PawelWilczewski/weti_indeks/img/obw1.JPG

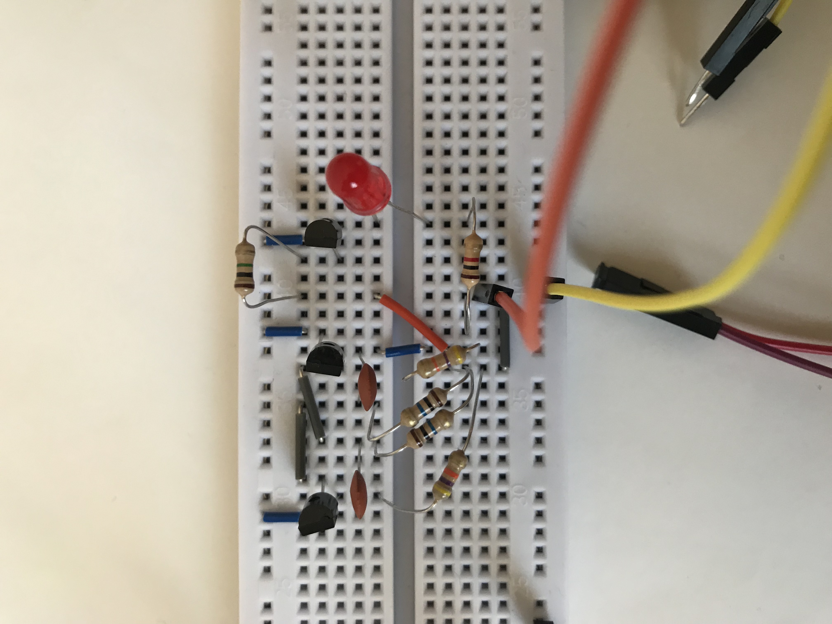
img/obw1.JPG
