PawelWilczewski/weti_indeks/img/obudowa.png

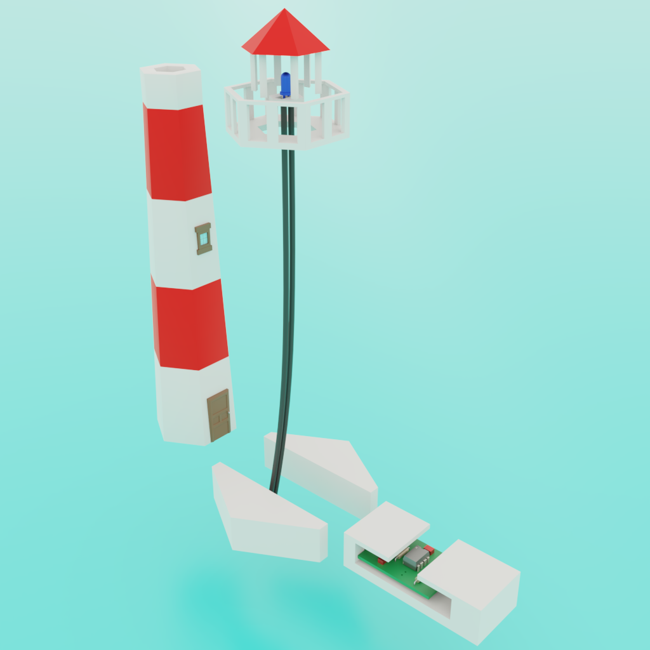
img/obudowa.png
