PawelWilczewski/weti_indeks/koszty.pdf

LP. | Przedmiot | Sztuk | Średnia cena za szt. | Cena | Link
1 | Timer 555 CMOS | 1 | 2.80 zł | 2.80 zł | https://kamami.pl/timery/19669-icm555.html
2 | Rezystor R1 1 MΩ | 1 | 0.02 zł | 0.02 zł | https://botland.com.pl/pl/zestawy-rezystorow/1039-zestaw-rezystorow-cf-tht-14w-
opisany-1000szt.html (https://botland.com.pl/pl/zestawy-rezystorow/1039-zestaw-rezystorow-cf-tht-14w-opisany-1000szt.html)
3 | Rezystor R2 6.8 MΩ | 1 | 0.20 zł | 0.20 zł | https://www.aprovi.pl/produkt/rezystor-weglowy-6m8-1w-%C2%B15/
4 | Rezystor R3 470 Ω | 1 | 0.02 zł | 0.02 zł | https://botland.com.pl/pl/zestawy-rezystorow/1039-zestaw-rezystorow-cf-tht-14w-
opisany-1000szt.html (https://botland.com.pl/pl/zestawy-rezystorow/1039-zestaw-rezystorow-cf-tht-14w-opisany-1000szt.html)
5 | Dioda LED | 1 | 0.16 zł | 0.16 zł | https://botland.com.pl/pl/diody-led/4741-zestaw-diod-led-5mm-16szt.html
6 | Kondensator 100 nF | 1 | 0.07 zł | 0.07 zł | https://botland.com.pl/pl/zestawy-kondensatorow/2146-zestaw-kondensatorow-ceramicznych-tht-100szt.html (https://botland.com.pl/pl/zestawy-kondensatorow/2146-zestaw-kondensatorow-ceramicznych-tht-100szt.html)
7 | Zworka | 2 | 0.10 zł | 0.20 zł | https://botland.com.pl/pl/zworki/556-zworka-jumper-10szt.html
8 | Gniazdo USB typu A | 1 | 0.70 zł | 0.70 zł | https://botland.com.pl/pl/zlacza-usb/1329-gniazdo-usb-typu-a-zenskie-tht.html
9 | Wtyk goldpin | 4 | 0.02 zł | 0.07 zł | https://botland.com.pl/pl/gniazda-szpilkowe-goldpin/192-wtyk-goldpin-1x40-prosty-raster-254mm.html (https://botland.com.pl/pl/gniazda-szpilkowe-goldpin/192-wtyk-goldpin-1x40-prosty-raster-254mm.html)
10 | Wykonanie PCB | 1 | 42.16 zł | 42.16 zł | https://www.prototypy.com/sites_pcbplugins/pcborder/58
| | | SUMA | 46.39 zł
| | | SUMA bez PCB | 4.23 zł

Tabela z kosztem elementów wykorzystanych do budowy Ekomigacza
