PawelWilczewski/weti_indeks/img/ATTiny45_Program.png

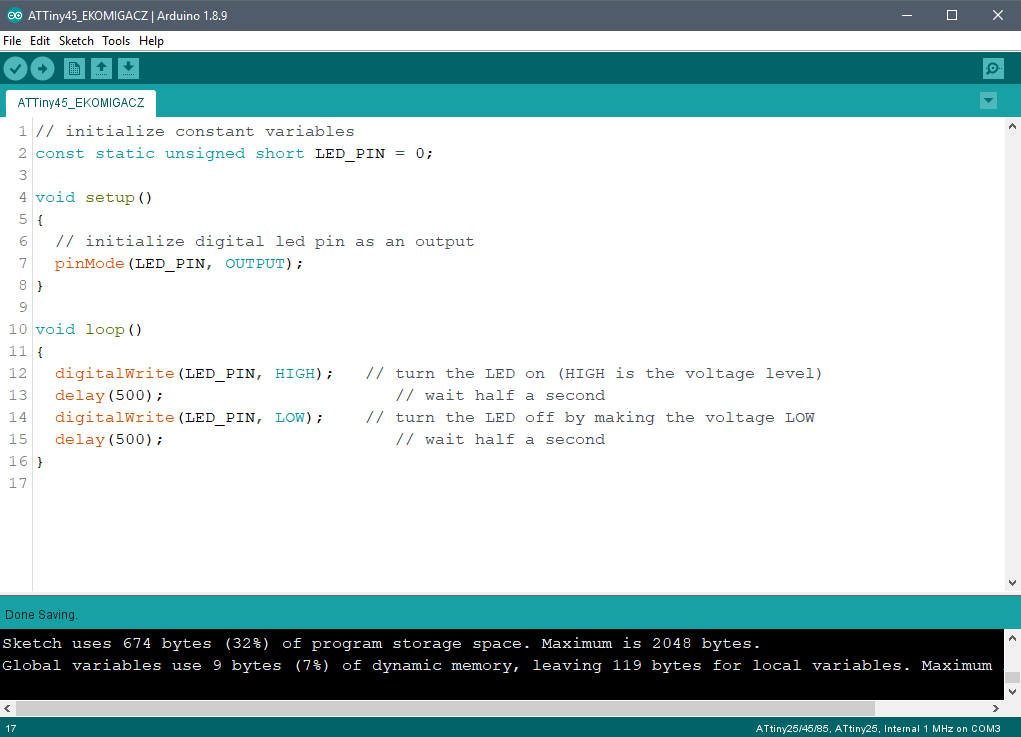
img/ATTiny45_Program.png
