PawelWilczewski/weti_indeks/img/czas.png

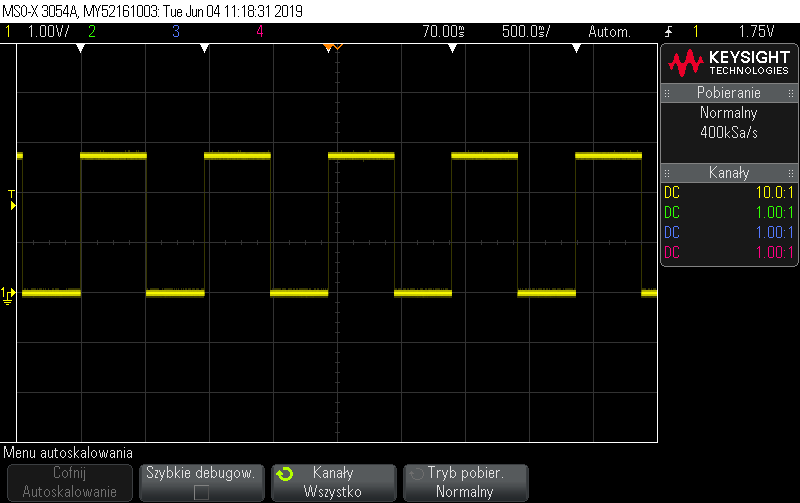
img/czas.png
