PawelWilczewski/weti_indeks/img/dioda.png

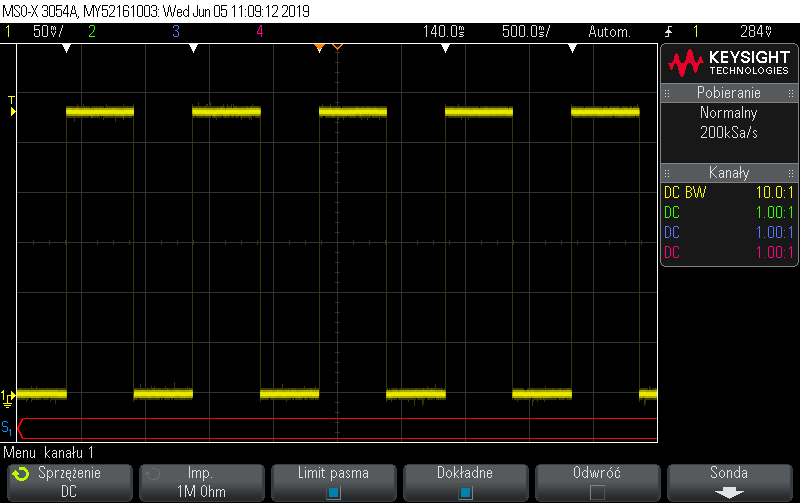
img/dioda.png
