PawelWilczewski/weti_indeks/img/IMG_3310.JPG

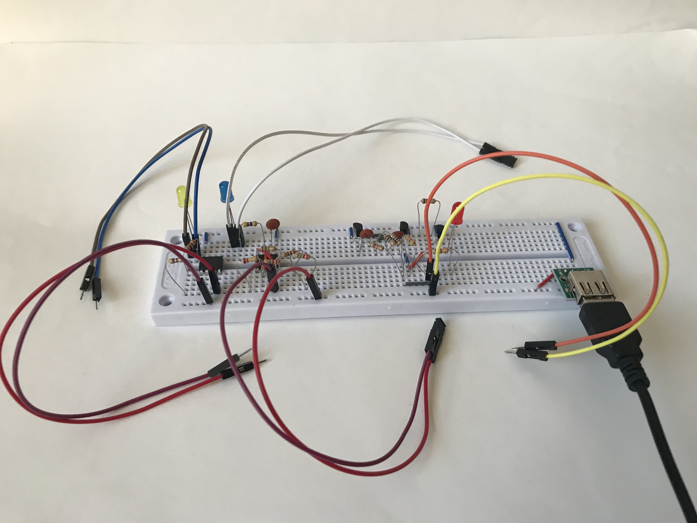
img/IMG_3310.JPG
