PawelWilczewski/weti_indeks/img/IMG_3311.JPG

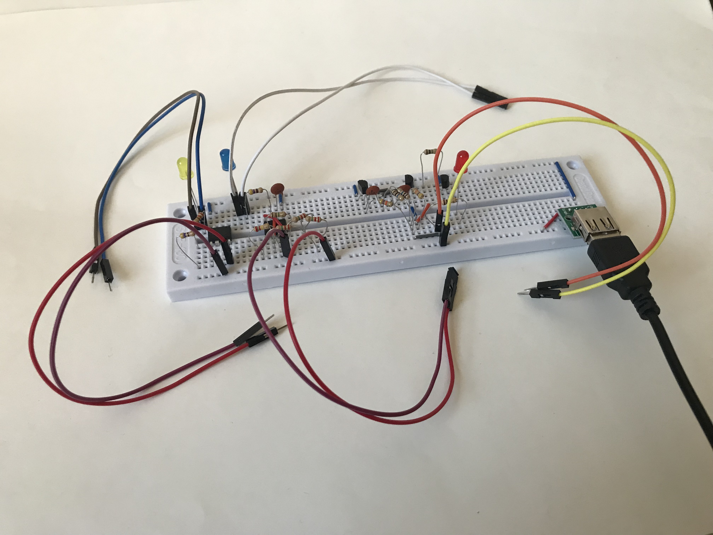
img/IMG_3311.JPG
