PawelWilczewski/weti_indeks/img/IMG_3313.JPG

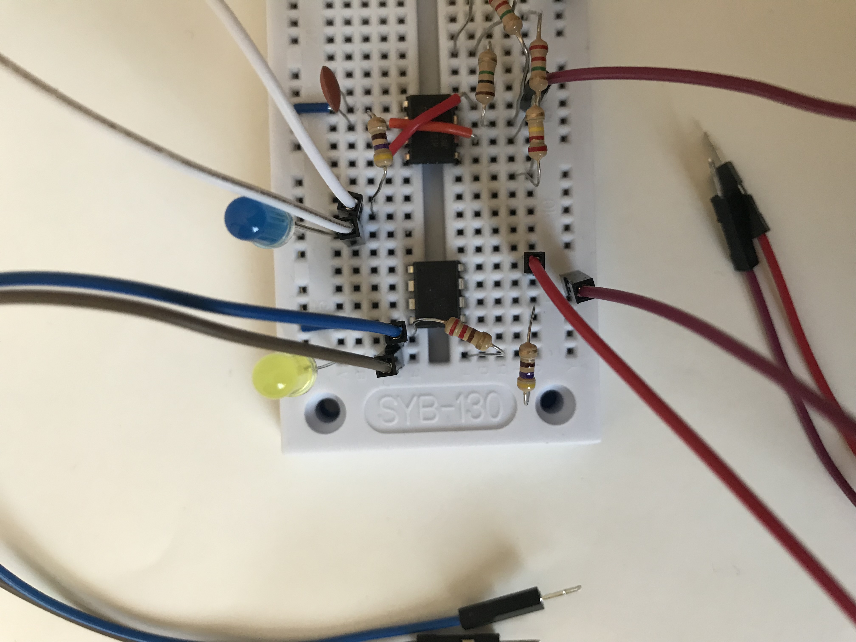
img/IMG_3313.JPG
