PawelWilczewski/weti_indeks/img/IMG_3314.JPG

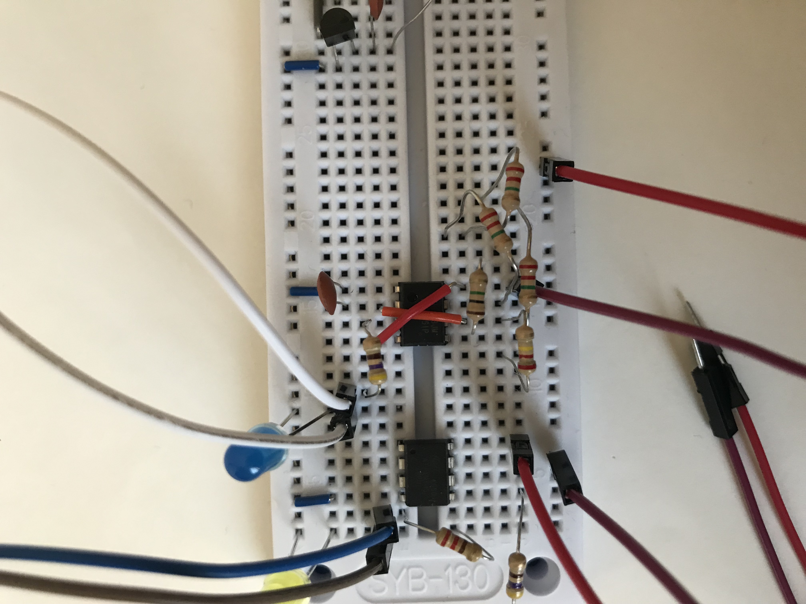
img/IMG_3314.JPG
