PawelWilczewski/weti_indeks/img/IMG_3316.JPG

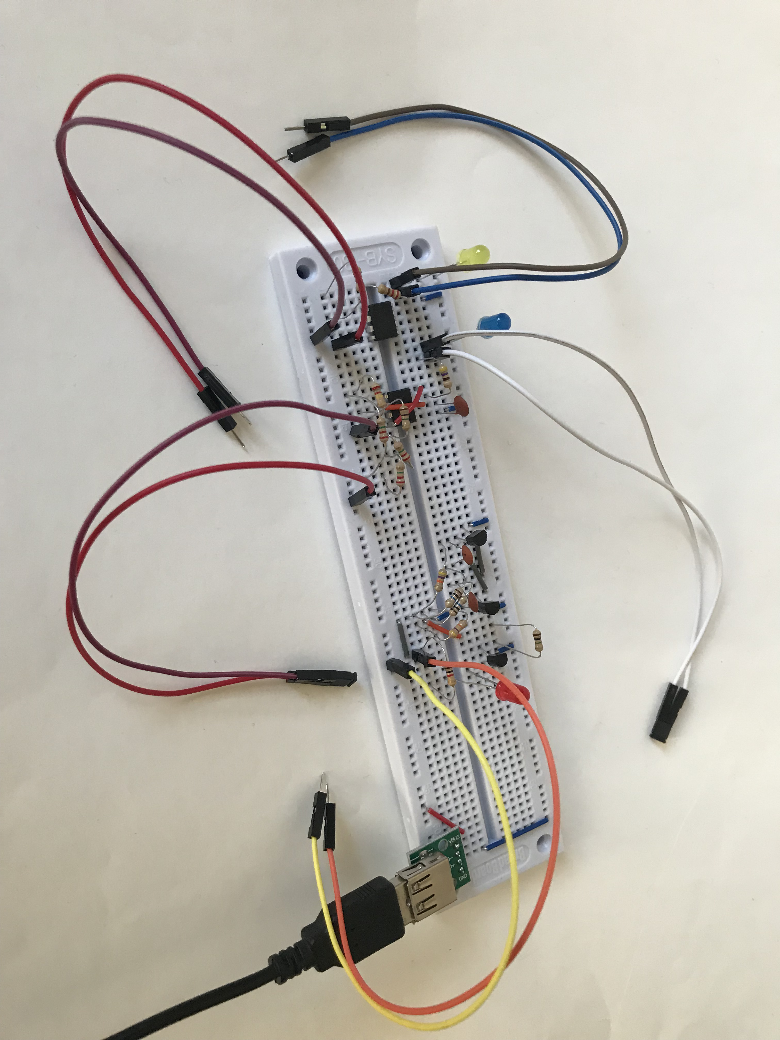
img/IMG_3316.JPG
