PawelWilczewski/weti_indeks/img/IMG_3317.JPG

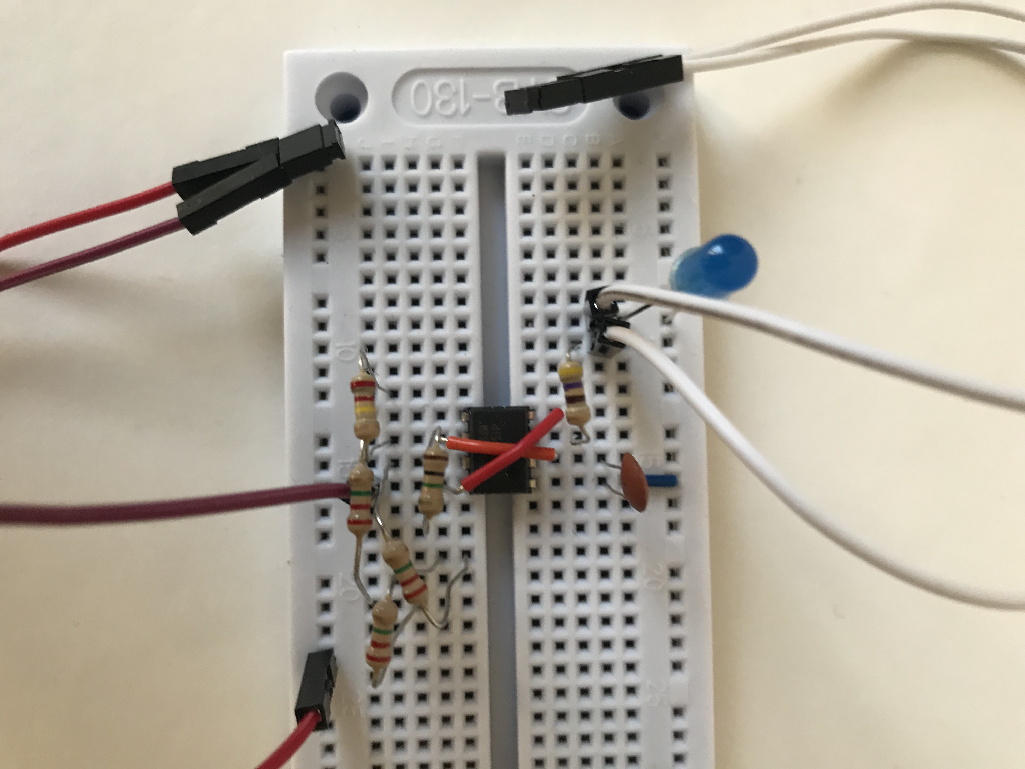
img/IMG_3317.JPG
