PawelWilczewski/weti_indeks/img/IMG_3318.JPG

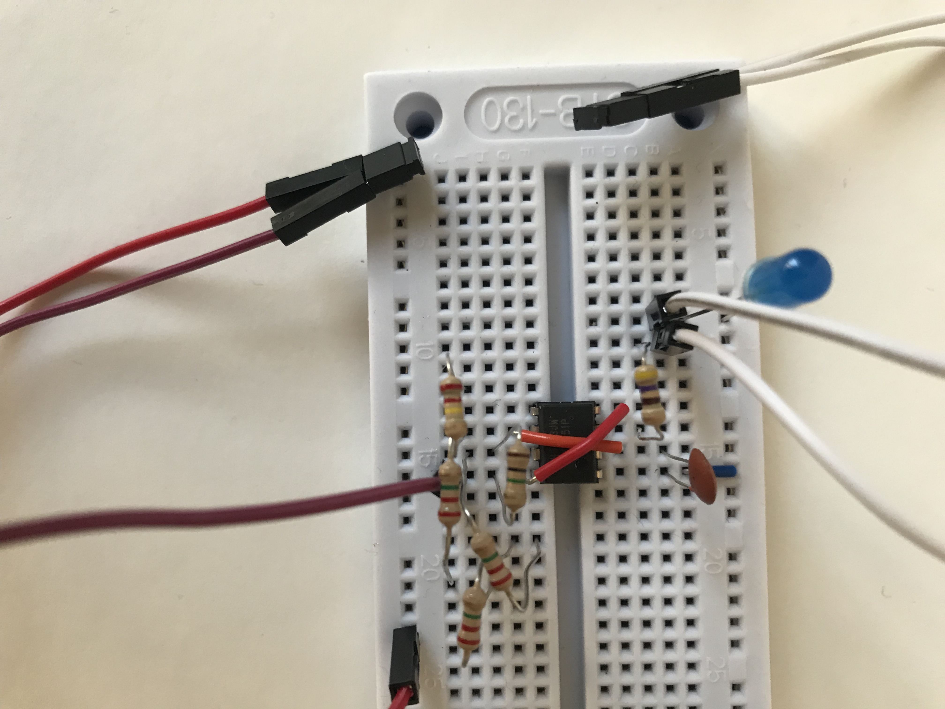
img/IMG_3318.JPG
