PawelWilczewski/weti_indeks/img/IMG_3319.JPG

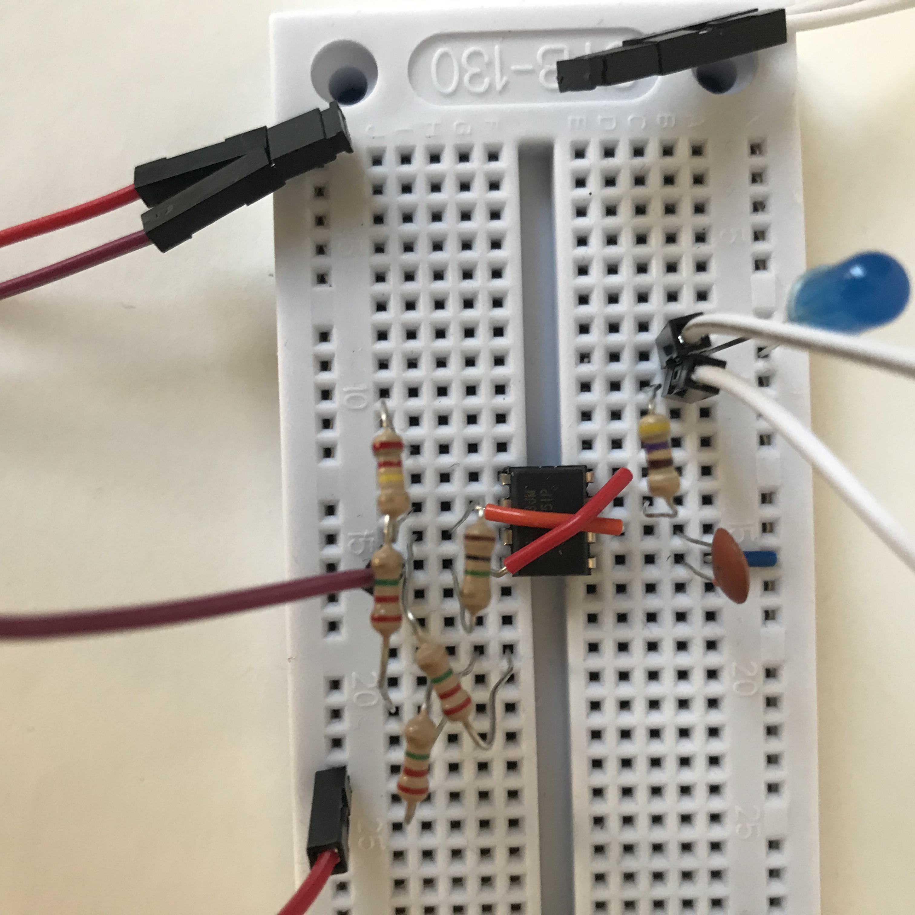
img/IMG_3319.JPG
