PawelWilczewski/weti_indeks/img/latarnia_real.jpg

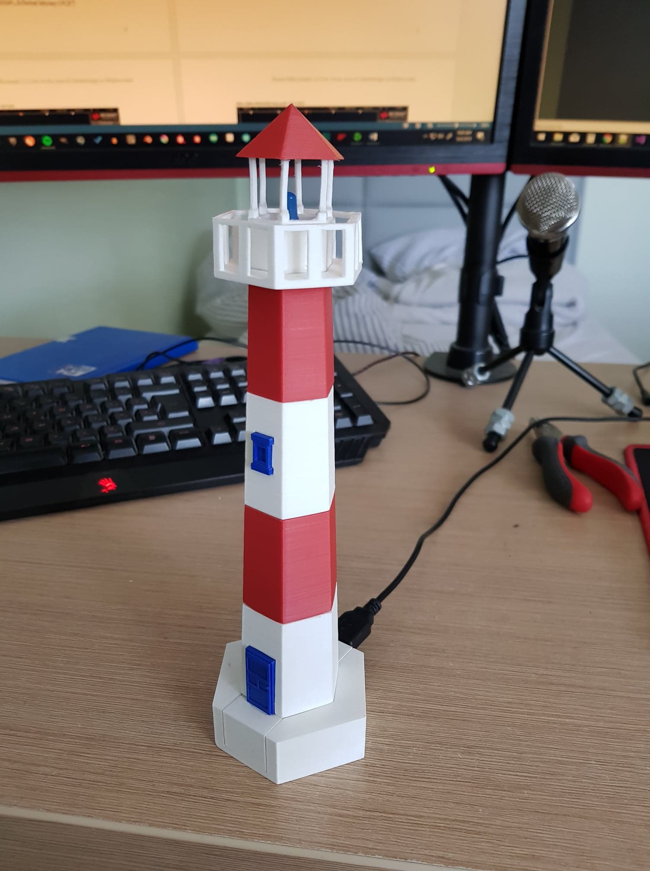
img/latarnia_real.jpg
