PawelWilczewski/weti_indeks/img/latarnia_real.png

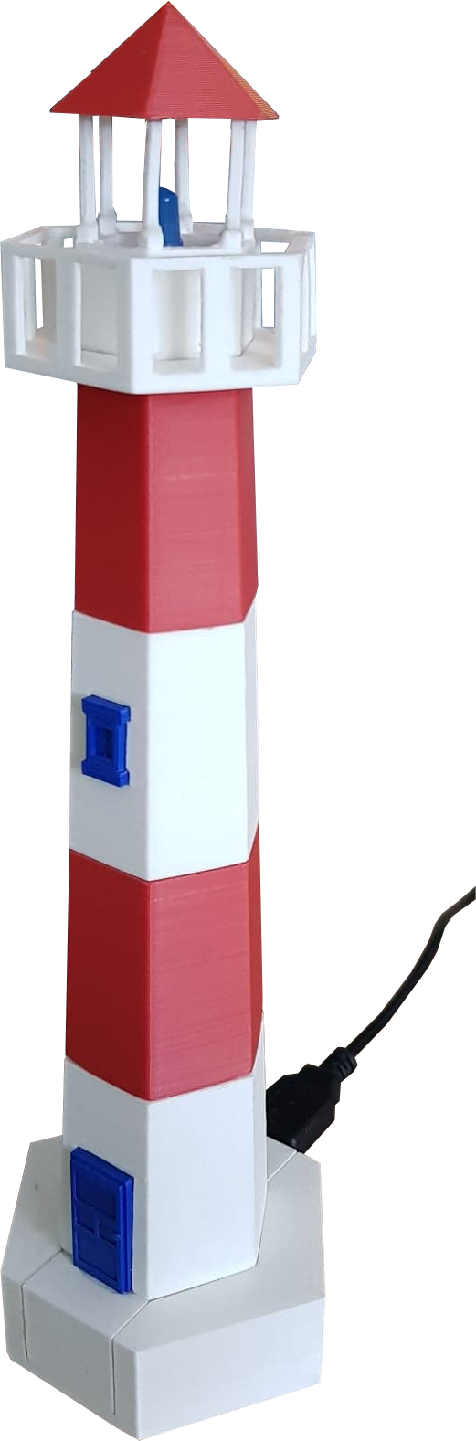
img/latarnia_real.png
