PawelWilczewski/weti_indeks/img/pomiar.png

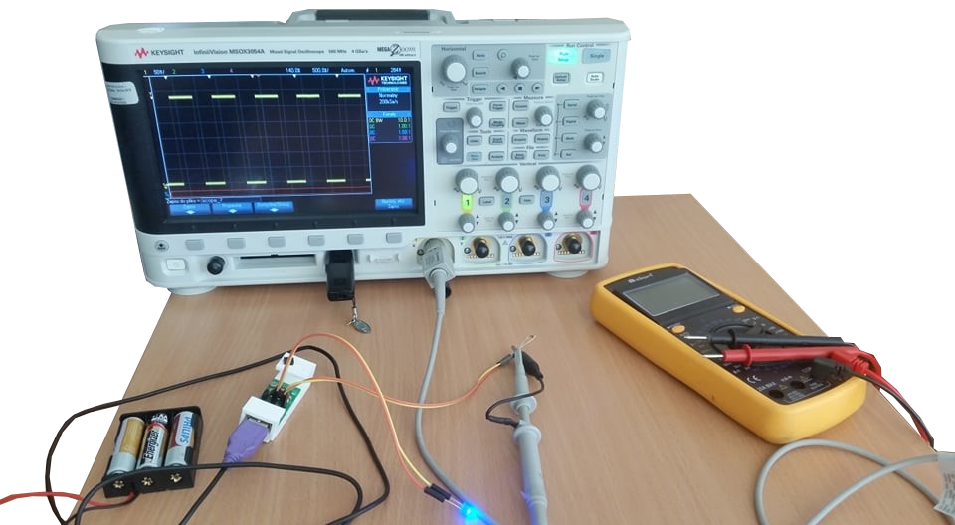
img/pomiar.png
