PawelWilczewski/weti_indeks/img/pomiar_tr.png

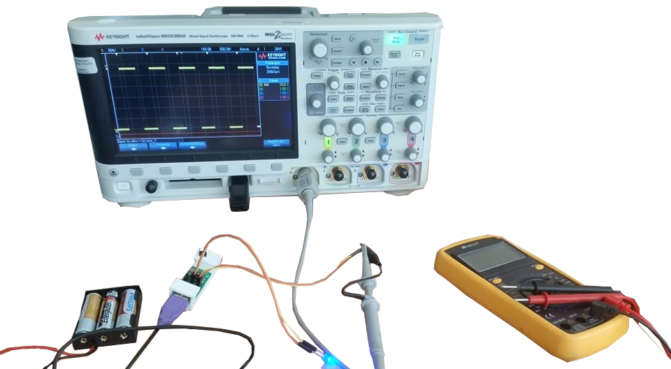
img/pomiar_tr.png
