PawelWilczewski/weti_indeks/img/płytka.png

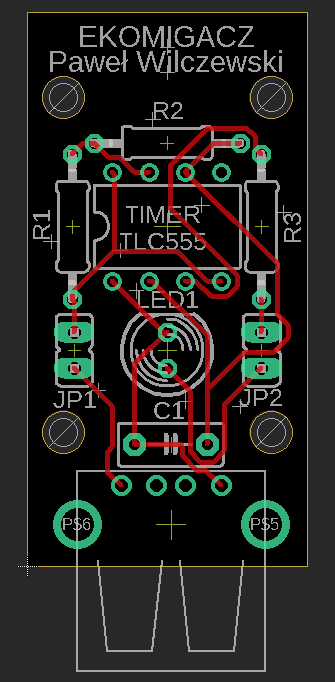
img/płytka.png
