PawelWilczewski/weti_indeks/img/schemat.png

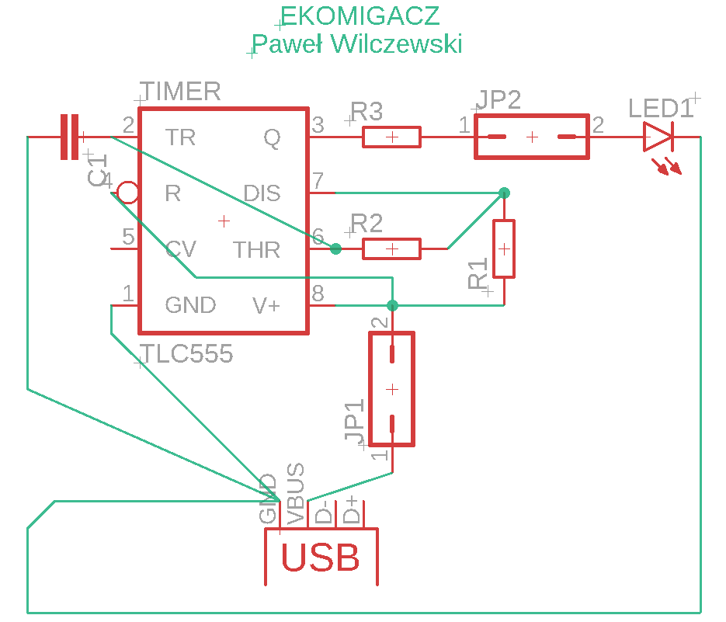
img/schemat.png
