PawelWilczewski/weti_indeks/img/zasilanie.png

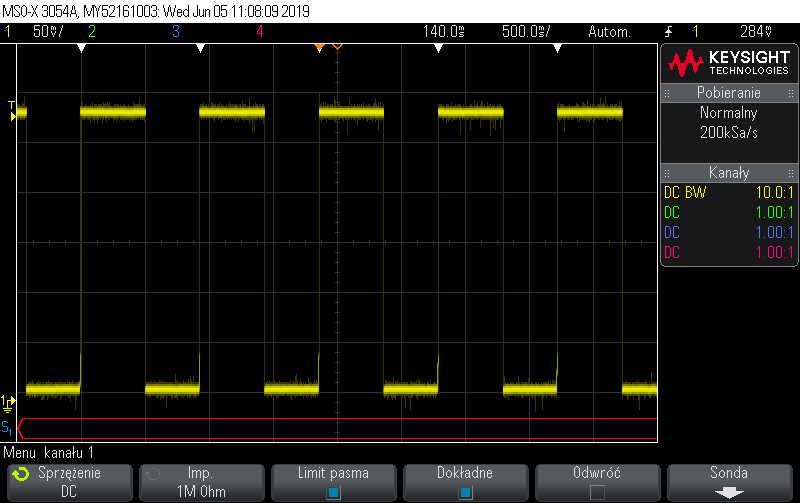
img/zasilanie.png
