PawelWilczewski/weti_indeks/data/measurements.xlsx

1 hz
R1 (kOhm) | R2 (kOhm) | MIN (mA) | MAX (mA)
220 | 739 | 2.44 | 3.83
too long duty cycle
R1 (kOhm) | R2 (kOhm) | MIN (mA) | MAX (mA)
220 | 739 | 2.44 | 3.83
1 hz
R1 (kOhm) | R2 (kOhm) | MIN (mA) | MAX (mA)
220 | 737 | 2.44 | 3.83
 | 3.359090909 |  | 297.699594
