PawelWilczewski/weti_indeks/pcb/pcb_order.png

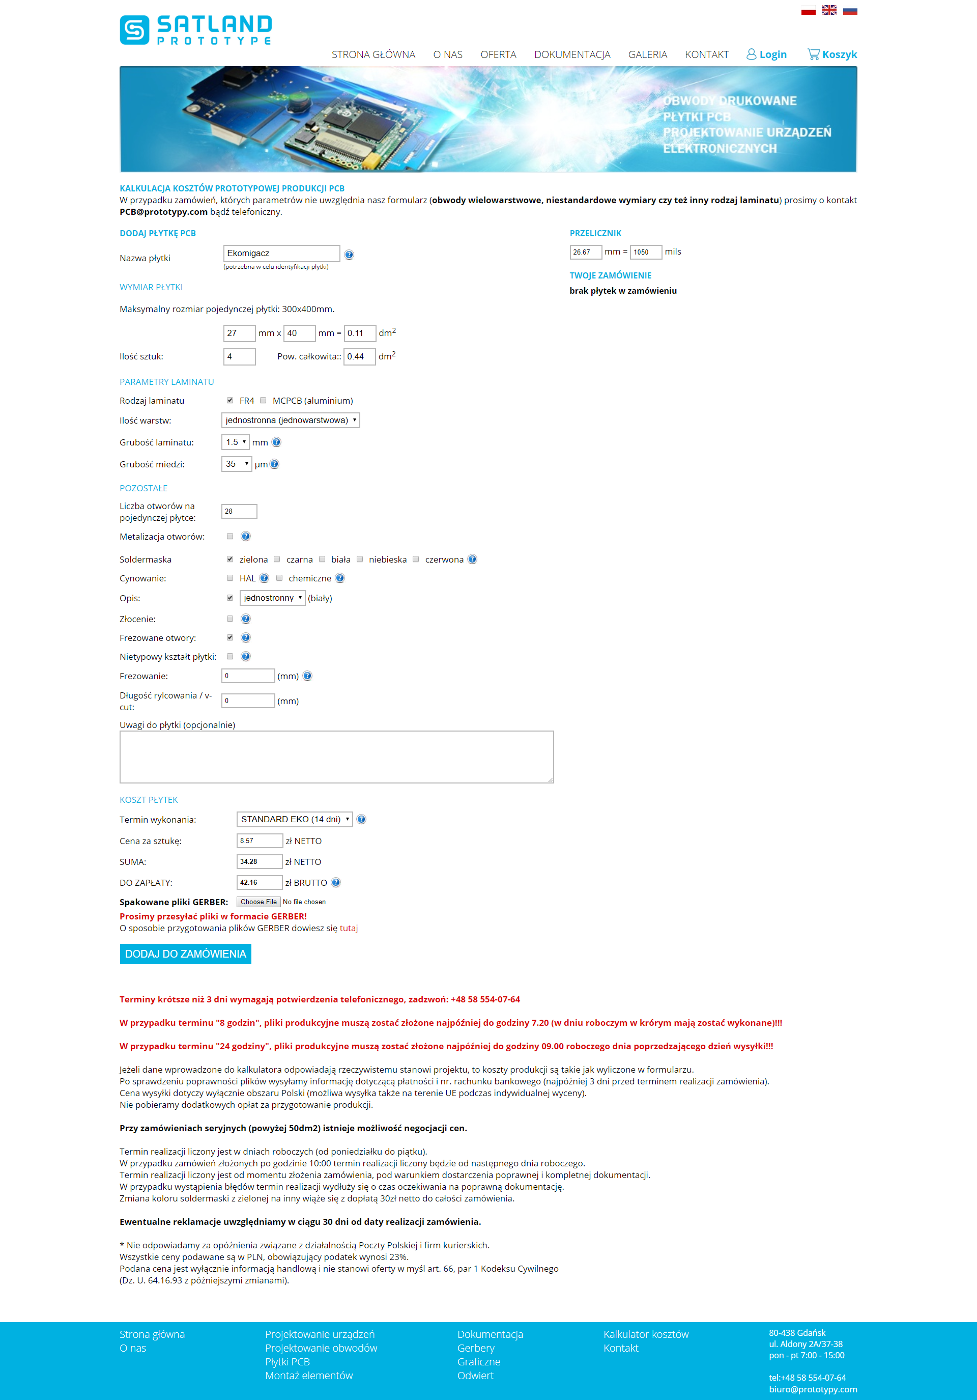
pcb/pcb_order.png
