PawelWilczewski/weti_indeks/img/ekomigacz_PCB.dxf

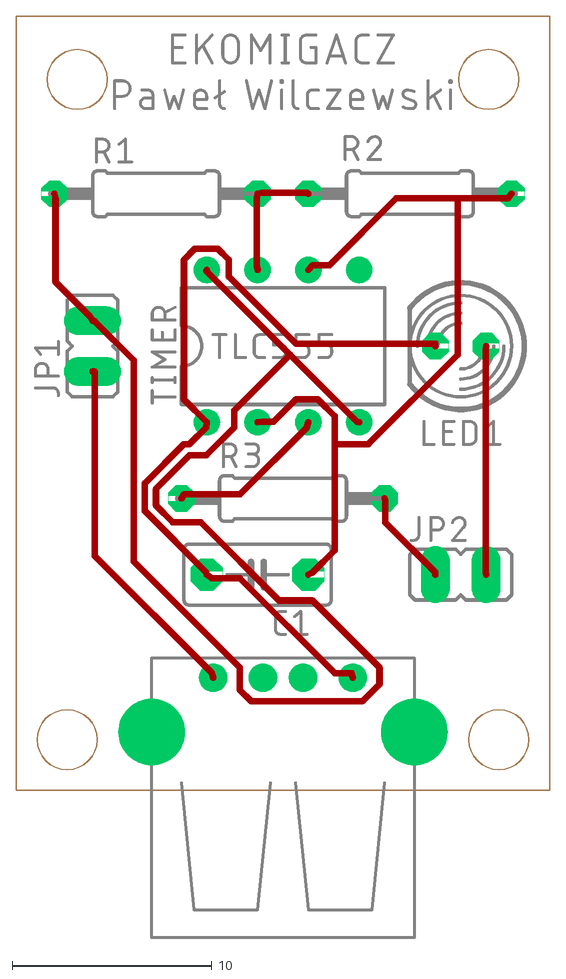
[picture p33: CAD file, 2019-04-28]
img/ekomigacz_PCB.dxf
26.7 x 46.2
