PawelWilczewski/weti_indeks/model/eksport/bialy/latarnia_3.stl

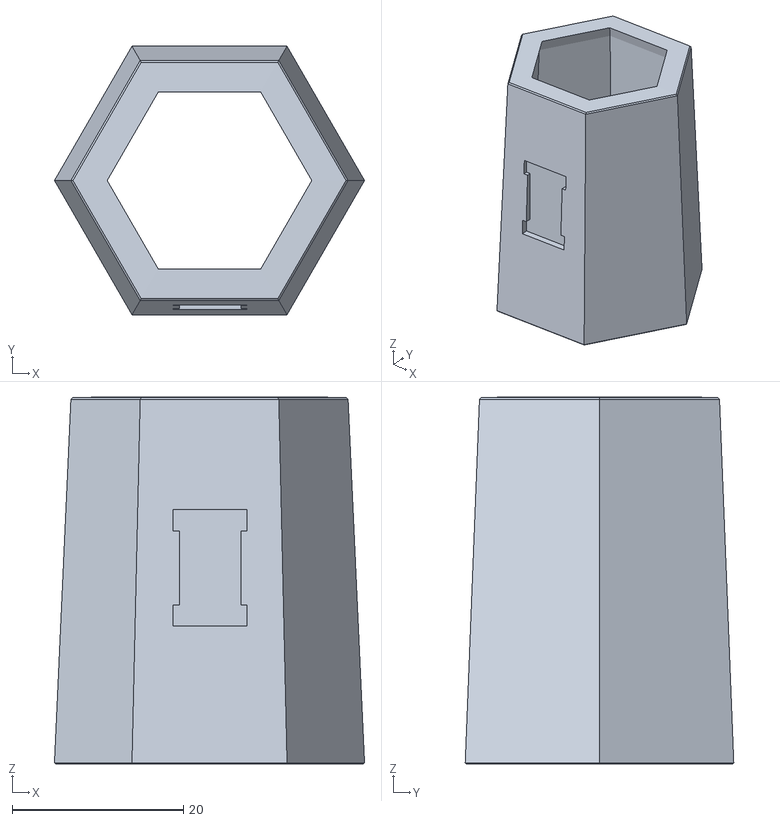
[picture p34: CAD file, 2019-05-05]
model/eksport/bialy/latarnia_3.stl
36.2 x 31.4 x 42.9
