PawelWilczewski/weti_indeks/model/eksport/brazowy/okno.stl

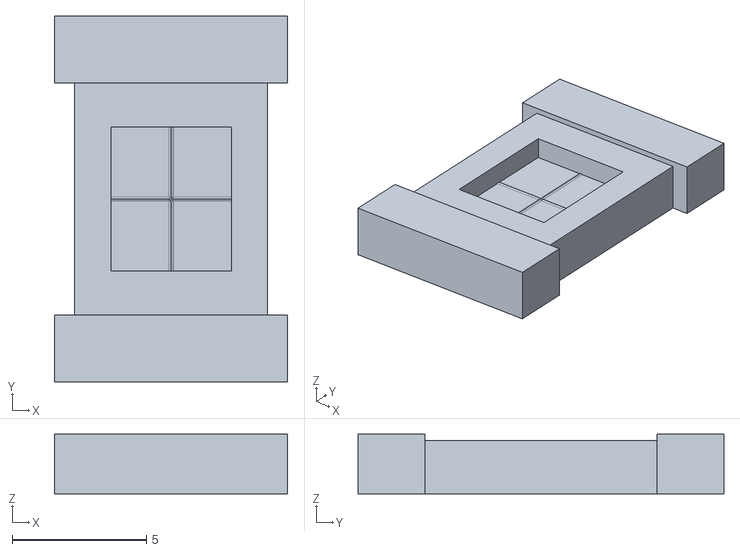
[picture p35: CAD file, 2019-05-05]
model/eksport/brazowy/okno.stl
8.68 x 13.6 x 2.23
