PawelWilczewski/weti_indeks/model/eksport/czerwony/latarnia_2.stl

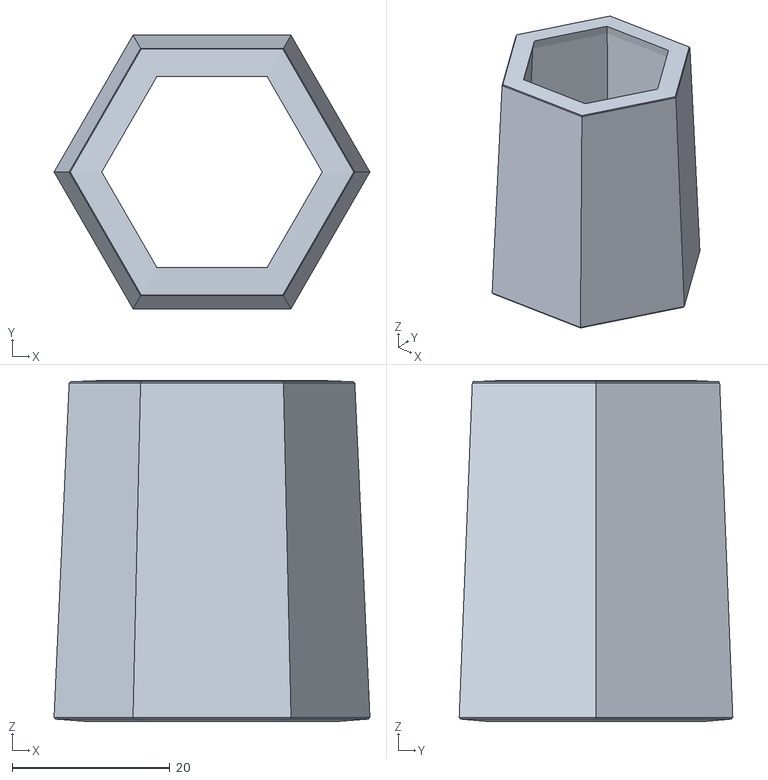
[picture p36: CAD file, 2019-05-05]
model/eksport/czerwony/latarnia_2.stl
40.1 x 34.7 x 43.3
