PawelWilczewski/weti_indeks/model/obudowa_ready.stl

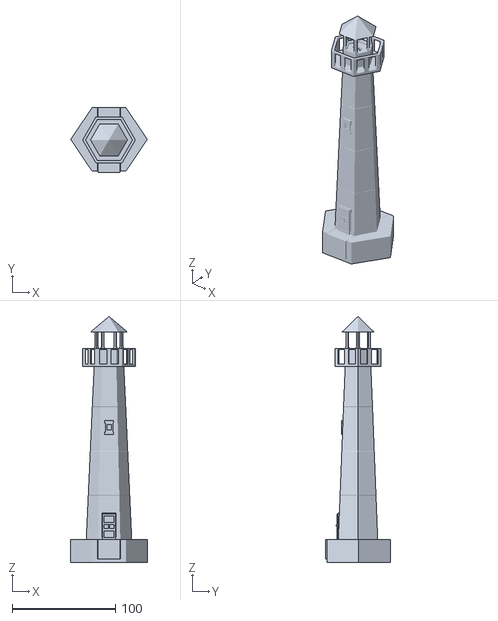
[picture p37: CAD file, 2019-05-05]
model/obudowa_ready.stl
74.1 x 62.5 x 237.9
