PawelWilczewski/weti_indeks/pcb/ekomigacz_PCB.dxf

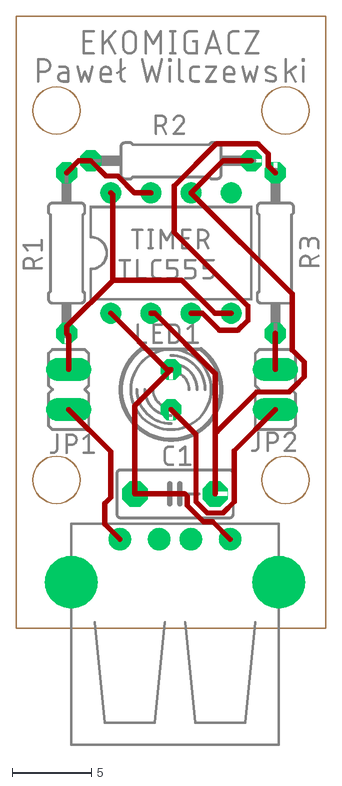
[picture p38: CAD file, 2019-05-02]
pcb/ekomigacz_PCB.dxf
19.6 x 46.2
