PawelWilczewski/weti_indeks/model/ekomigacz.obj

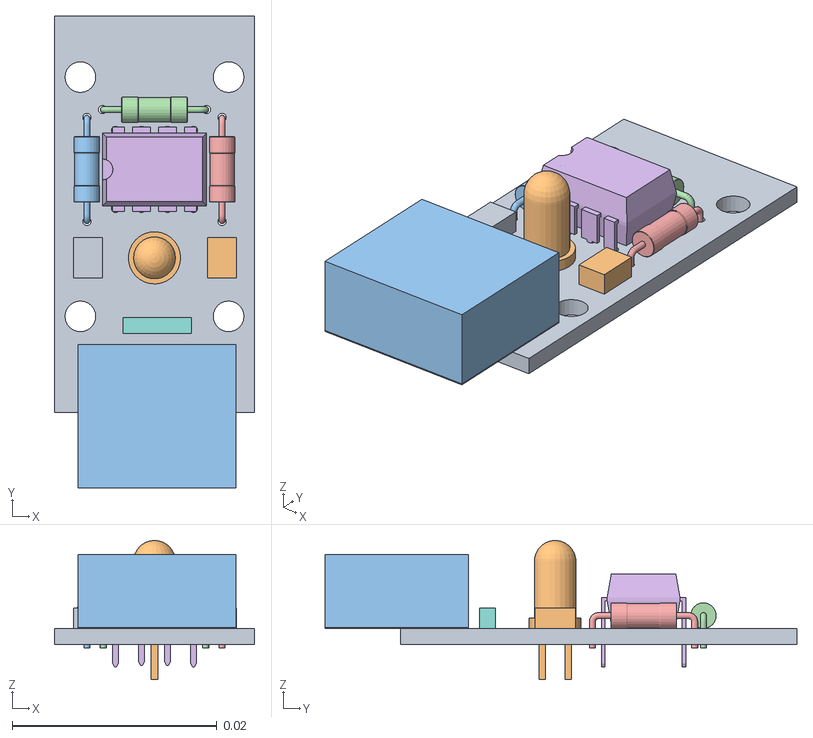
[picture p39: CAD file, 2019-05-02]
model/ekomigacz.obj
0.0196 x 0.0461 x 0.0136
Board
USB-A-H
C5B3
JP1
JP1:1
