PawelWilczewski/weti_indeks/model/eksport/bialy/podstawka_pod_led.stl

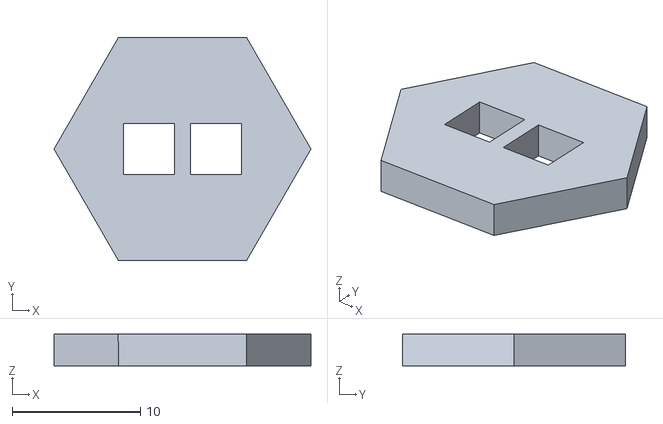
[picture p40: CAD file, 2019-05-05]
model/eksport/bialy/podstawka_pod_led.stl
20.0 x 17.4 x 2.50
