PawelWilczewski/weti_indeks/model/eksport/brazowy/drzwi.stl

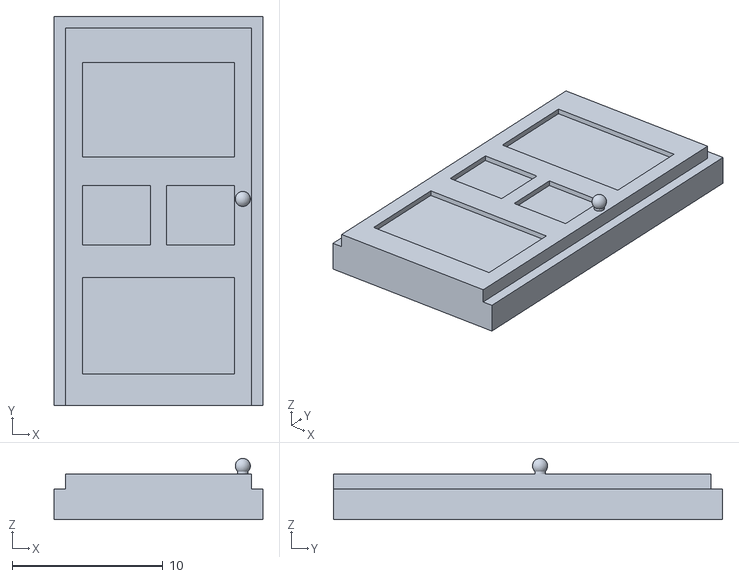
[picture p41: CAD file, 2019-05-05]
model/eksport/brazowy/drzwi.stl
13.9 x 25.8 x 4.07
