PawelWilczewski/weti_indeks/model/eksport/czerwony/dach.stl

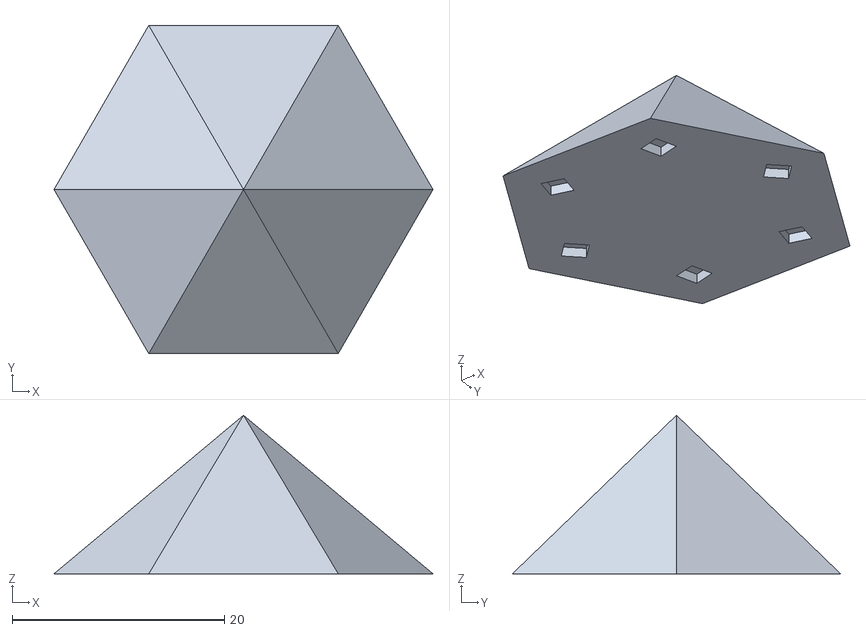
[picture p42: CAD file, 2019-05-05]
model/eksport/czerwony/dach.stl
35.7 x 30.9 x 14.9
