PawelWilczewski/weti_indeks/model/eksport/bialy/szufladka.stl

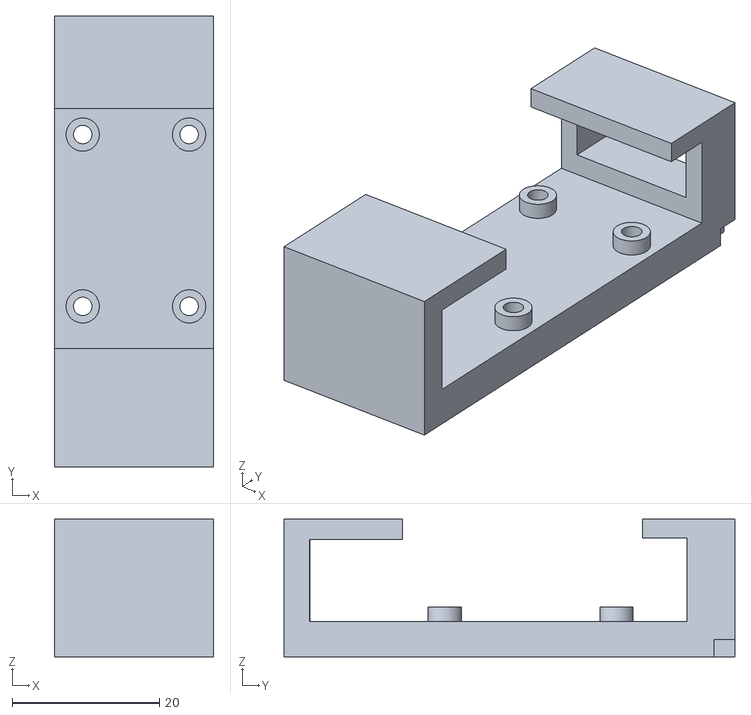
[picture p43: CAD file, 2019-05-05]
model/eksport/bialy/szufladka.stl
21.7 x 61.3 x 18.8
