PawelWilczewski/weti_indeks/model/eksport/czerwony/latarnia_4.stl

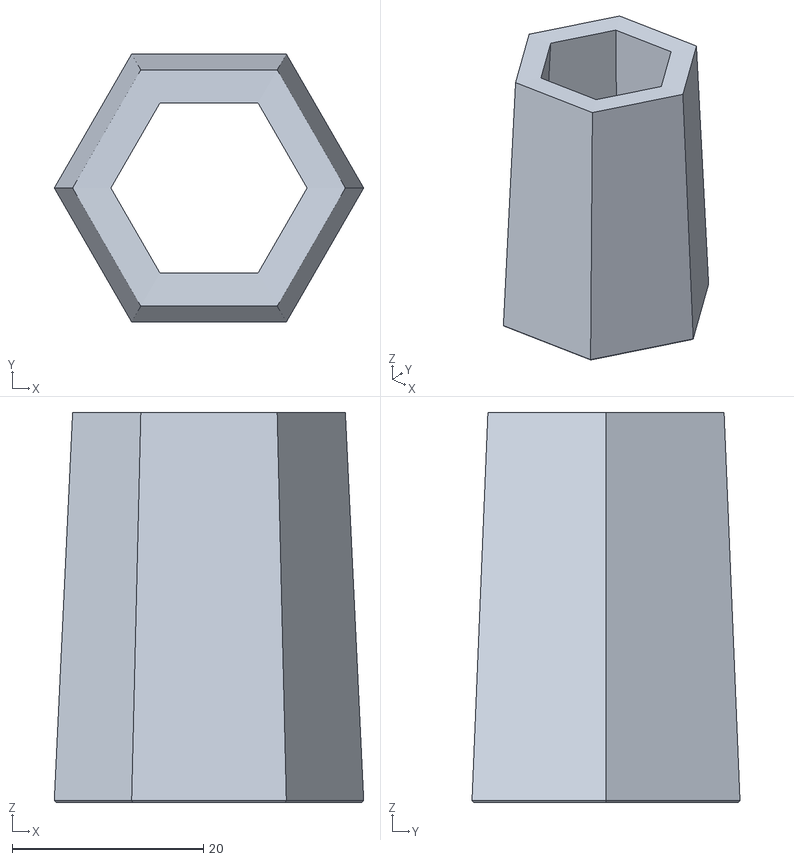
[picture p44: CAD file, 2019-05-05]
model/eksport/czerwony/latarnia_4.stl
32.4 x 28.0 x 40.8
