PawelWilczewski/weti_indeks/model/obudowa.stl

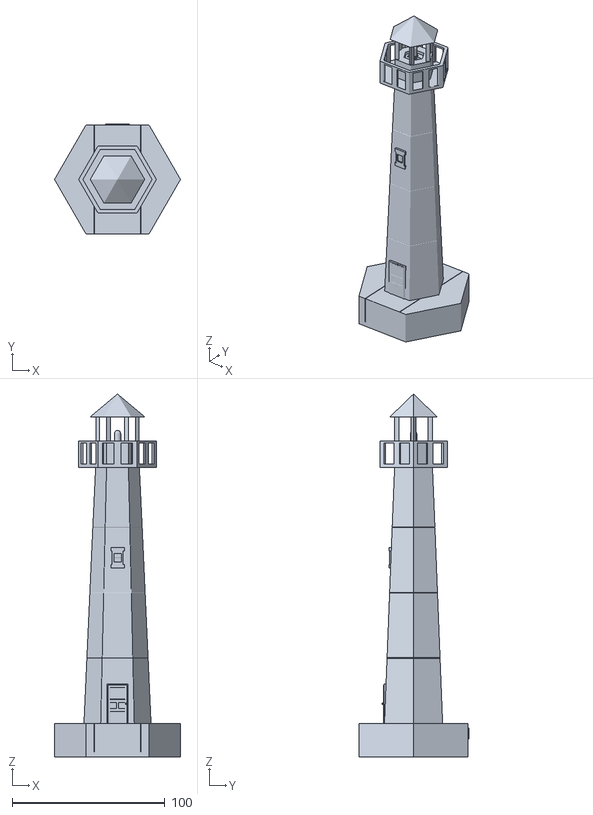
[picture p45: CAD file, 2019-04-28]
model/obudowa.stl
82.6 x 72.1 x 237.9
