PawelWilczewski/weti_indeks/model/eksport/bialy/latarnia_5.stl

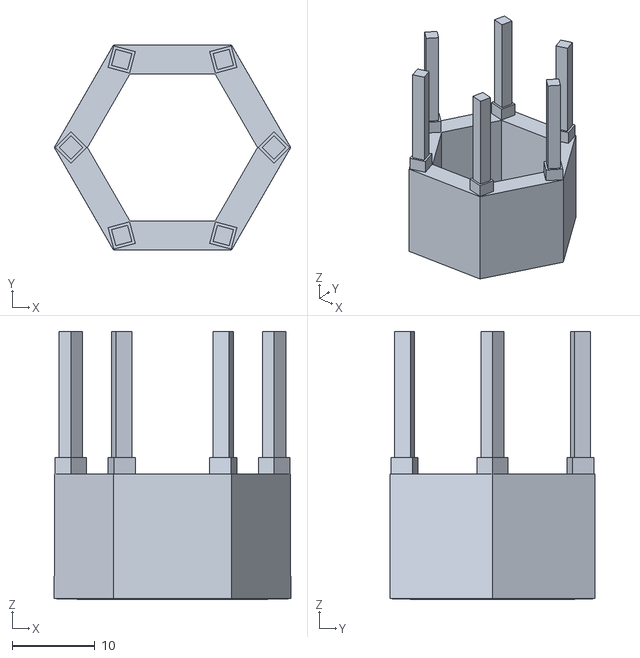
[picture p46: CAD file, 2019-05-05]
model/eksport/bialy/latarnia_5.stl
28.5 x 24.7 x 32.3
