PawelWilczewski/weti_indeks/model/eksport/bialy/latarnia_1.stl

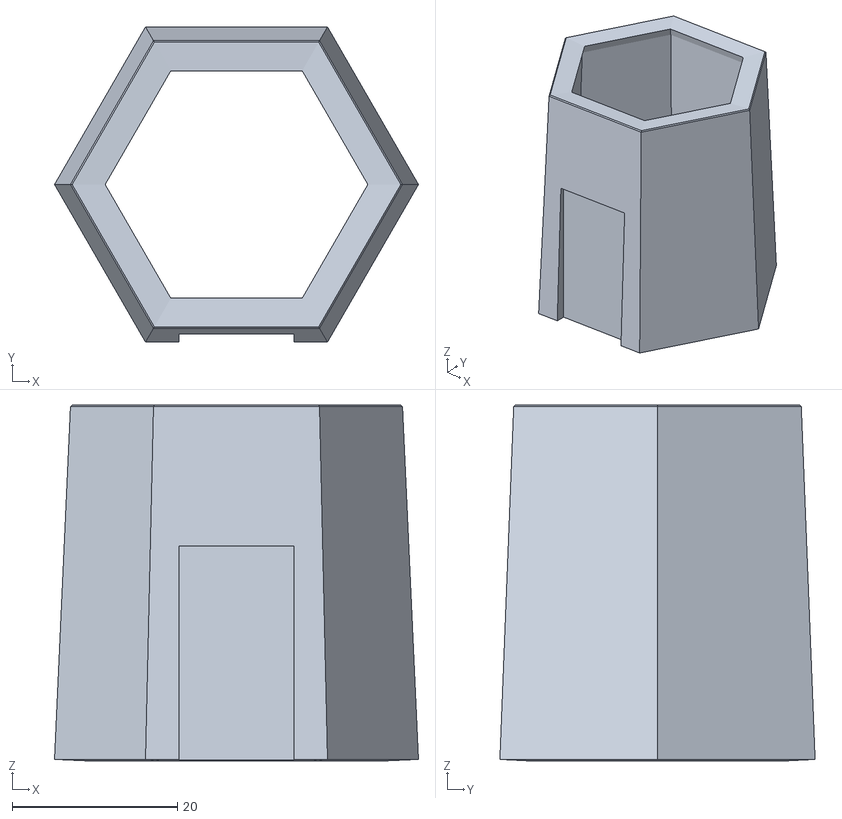
[picture p47: CAD file, 2019-05-05]
model/eksport/bialy/latarnia_1.stl
44.0 x 38.1 x 43.0
