PawelWilczewski/weti_indeks/model/eksport/bialy/baza.stl

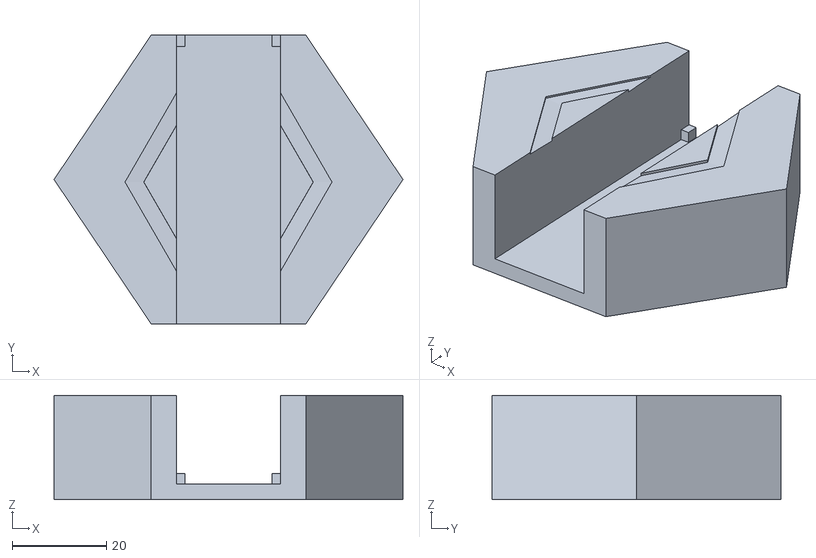
[picture p48: CAD file, 2019-05-05]
model/eksport/bialy/baza.stl
74.1 x 61.4 x 22.1
