PawelWilczewski/weti_indeks/model/eksport/bialy/barierki.stl

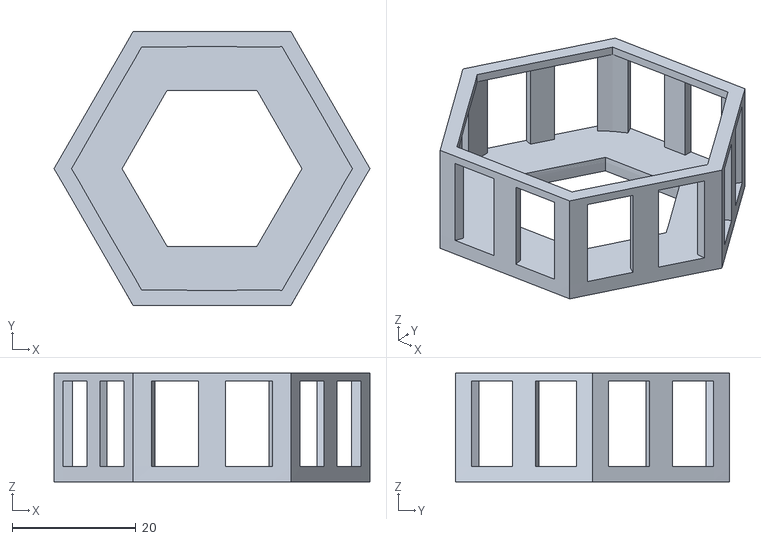
[picture p49: CAD file, 2019-05-05]
model/eksport/bialy/barierki.stl
51.0 x 44.2 x 17.5
