PawelWilczewski/weti_indeks/(list of files, cad)

Other CAD files:
model/obudowa_nowa.blend
model/obudowa_przed_bool.blend
