PawelWilczewski/weti_indeks/pcb/ekomigacz.brd

## EAGLE design pcb/ekomigacz.brd (2019-05-02)

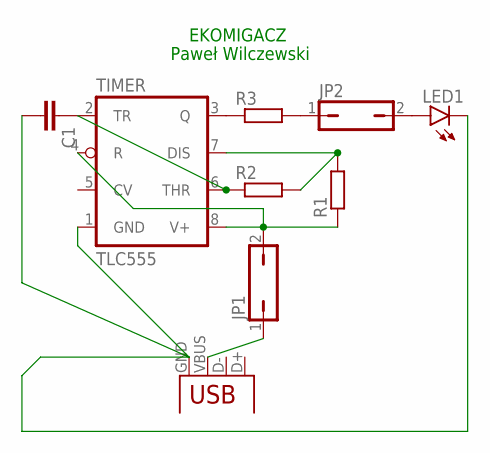
[picture p50: schematic ekomigacz.sch]

Parts:
C1: C5/3; C5B3
JP1, JP2: JP1Q; JP1
LED1: LED5MM
R1, R2, R3: R-EU_0207/10; 0207/10
TIMER: TLC555; DIL08
X1: USB-A-H

Connections:
5V: R3.1, TIMER.3 (Q)
unnamed: JP1.1, X1.VBUS
unnamed: R1.2, R2.2, TIMER.7 (DIS)
unnamed: JP1.2, R1.1, TIMER.4 (R), TIMER.8 (V+)
unnamed: C1.1, R2.1, TIMER.2 (TR), TIMER.6 (THR)
unnamed: JP2.1, R3.2
unnamed: JP2.2, LED1.A
unnamed: C1.2, LED1.K (C), TIMER.1 (GND), X1.GND

Notes on the sheet:
EKOMIGACZ
Paweł Wilczewski

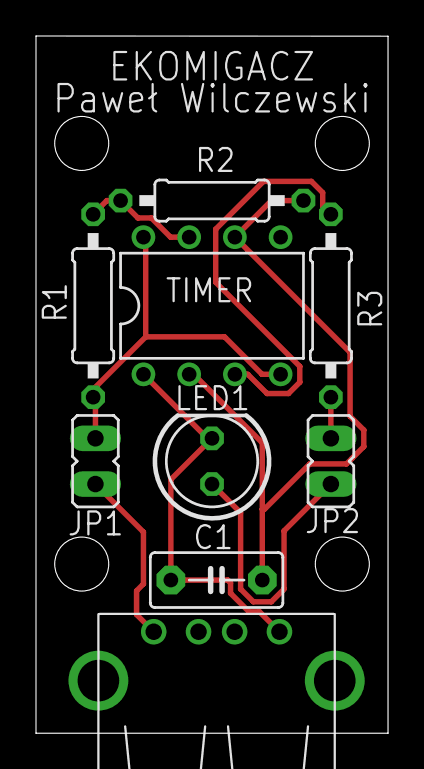
[picture p51: board ekomigacz.brd from above]

Board: 2 copper layers, 19.6 x 38.7 mm, 9 parts (0 on the bottom side), 8 nets.
