PawelWilczewski/weti_indeks/(commit log)

2019-03-28 Adding files to repo
    [circuit.sch, wawatam_lighthouse_case.stl]
2019-04-07 First stage
    [PowerConsumption.xlsx, circuit.sch, ekomigacz.brd, ekomigacz.sch, ekomigacz_3R.brd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]
2019-04-29 model update
    [obudowa_nowa.blend]
2019-05-02 PCB and model update
    [ekomigacz.brd, ekomigacz.obj, ekomigacz_PCB.dxf]
2019-05-05 final case
    [barierki.stl, baza.stl, dach.stl, drzwi.stl, latarnia_1.stl, latarnia_2.stl, latarnia_3.stl, latarnia_4.stl]
